BaguettePNG/PTrans-2025-2026/Documentation/Rapport_Tech_Final/main.pdf

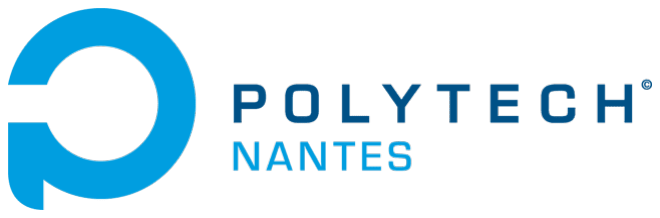
[picture p3: figure]

# RAPPORT TECHNIQUE FIN DE PROJET

## Projet transversal no

4

## Collecteur de données animalières

Équipe projet :
Davy Clark, Ewen Le Callet, Joris Menard, Jules Noumba, Xueying Xu

Client :
Xavier Leprevost – Élu de la mairie de Saint-Mars-du-Désert

Encadrants :
Abdelhakim Saadane et Antoine Goullet

Date :
09/03/2026

Année universitaire 2025–2026

## Remerciements

Nous tenons à remercier l’ensemble des personnes ayant contribué à la réalisation de ce projet transversal. Nous remercions particulièrement nos encadrants, Abdelhakim Saadane et Antoine Goullet, pour leur accompagnement, leurs conseils méthodologiques et leur disponibilité tout au long de l’année universitaire 2025–2026.
Nous remercions également notre client, Xavier Leprevost, élu de la mairie de Saint-Mars-du-Désert, pour sa confiance, la clarté de ses besoins et la qualité des échanges durant le développement du collecteur de données animalières.

## Table des matières

Remerciements | 1
Table des figures | 4
Glossaire | 5
1 Introduction | 6
2 Présentation, contexte et spécifications | 6
3 Liste des Work-Packages : Objectifs, Solution, Validation | 6
3.1 WP 1.1 — Détection de mouvement et mesure de température (responsable : Jules

3.2 WP 1.2 — Gestion des échanges données et du microcontrôleur (responsable : Nolan

4 Bilan du projet | 22
5 Conclusion | 22
Bibliographie | 23
Annexes | 24
A Répartition détaillée des Work-Packages | 24
B Exemples de données collectées | 24

## Table des figures

1 | Pinout Diagramme de l’ESP32 | | 9
2 | Module de carte SD utilisé pour le projet | 10
3 | Module de carte SD utilisé pour le projet | 10
4 | Résultat du test d’écriture sur la carte SD | 11
5 | Courbe de résistance en fonction de la luminosité pour la photorésistance | 13
6 | Module GPS utilisé pour le projet | 15
7 | Exemple de trame NMEA envoyée par le module GPS | 15
8 | Trame GPRMC utilisée pour récupérer la localisation et l’horodatage | 16
9 | Schéma du principe de fonctionnement du module RTC pour maintenir l’heure en
temps réel | 17
10 | Chaîne d’acquisition et de traitement des images du module caméra | 19
11 | Influence de la résolution sur la taille des images JPEG et le temps de capture . . . . 20

## Glossaire

WP Un Work Package (WP) est une unité de travail dans un projet. Il regroupe un ensemble cohérent de tâches, d’objectifs et de livrables.

## 1 Introduction

Le projet Collecteur de données animalières s’inscrit dans le cadre du projet transversal 2025– 2026 mené par des étudiants de Polytech Nantes en collaboration avec la mairie de Saint-Mars-du-Désert.
L’objectif principal est de concevoir une solution permettant de collecter, structurer et exploiter des données relatives à la faune locale, afin d’améliorer le suivi du territoire et d’appuyer la prise de décision.
Ce rapport technique présente le contexte du projet, les besoins exprimés par le client, les choix techniques retenus, ainsi que l’avancement des travaux réalisés par l’équipe. Par ailleurs, la structuration en lots de travail s’inspire des bonnes pratiques de gestion de projet recommandées dans la littérature[1]. Par ailleurs, la structuration en lots de travail s’inspire des bonnes pratiques de gestion de projet recommandées dans la littérature[1].

## 2 Présentation, contexte et spécifications

### 2.1 Présentation de l’entreprise

### 2.2 Contexte général

### 2.3 Présentation du sujet de projet et Cahier des Charges

### 2.4 Etat de l’art

## 3 Liste des Work-Packages : Objectifs, Solution, Validation

Parler de la décomposition des WP, sous WP etc

### 3.1 WP 1.1 — Détection de mouvement et mesure de température (respon-

sable : Jules Noumba)

### 3.1.1 Rappel des objectifs

Détailler objectifs et liste des taches.

### 3.1.2 Solution envisagé

Travail théorique et recherches

### 3.1.3 Tests et Validation

Tests et validation de vos taches.

### 3.2 WP 1.2 — Gestion des échanges données et du microcontrôleur (respon-

sable : Nolan Buchet)

### 3.2.1 Rappel des objectifs

Pour recontextuatlisé le projet et les objectifs de ce Work Package, le WP 1.2 fait partie du Work parckage 1 qui est dédié à la conception et au développement du système de collecte de données animalières. Le WP 1.2 se concentre spécifiquement sur la gestion des échanges de données entre les différents composants du système, ainsi que sur l’intégration et la programmation du microcontrôleur qui servira de cerveau central pour le projet. De plus celui-ci s’occupera de la partie énergétique du module, ainsi que de la partie stockage des données collectées.

Voici la liste des taches qui seront réalisées dans le cadre de ce WP :
— Tache 0 ( Equipe ) : Choix du Microcontrôleur et de la carte SD — Tache 1 : Gestion du stockage des données collectées
— Tache 2 ( hors WP ) : Gestion de la luminosité pour WP 1.3
— Tache 3 ; Gestion de l’horodatage et de la localisation du modules
— Tache 4 : Définition d’un Automate pour la gestion global du module — Tache 5 : Développement d’une architecture electrique
— Tache 6 : Intégration des modules ( prototypage )
— Tache 7 : Gestion de l’alimentation du module
— Tache 8 : Création d’un PCB pour le module

Pour chacune des taches réalisée ci-dessus, il y a eu une phase de test réalisé, ainsi qu’en amont une phase de concertation avec l’équipe du WP afin que les solutions envisagées soient en adéquation avec les besoins du projet.

Certaines tâches de ce modules ne sont pas dans l’ordre de conception, en prenant la tache 4 ou 5 qui ont été en constante évolution durant tout le projet. Et certaine taches non essentielle, mais logique, comme l’optimisation des codes, ou rapport / documention ont été réalisé en parallèle de la conception du module.

### 3.2.2 Tache 0 : Choix du Microcontrôleur

Solution envisagé

À la suite d’une phase de recherche ( benchmark du début de projet ) concernant le contrôleur à utiliser pour ce projet, nous avons identifié deux solutions susceptibles de répondre à nos besoins : l’ESP32 et le Raspberry Pi Zero.

Pour rappel, les besoins principaux concernant le contrôleur étaient les suivants :

Critère | Description
Consommation énergétique | Minimiser la consommation pour un usage sur bat- terie.

Performances | Garantir une puissance suffisante pour le traitement des données.
Stockage | Disposer d’une capacité suffisante pour enregistrer temporairement les mesures locales et la photogra- phie.
Système | Offrir un environnement logiciel simple avec facilité sur les outils de développement utilisés.
Interfaces | Proposer des entrées/sorties adaptées aux capteurs et modules externes.
Connectivités | Intégrer ou supporter le Wi-Fi, le Bluetooth ou d’autres moyens de communication.
Prix | Rester dans une gamme de coût compatible avec le budget du projet.

Ces critères nous ont permis de comparer plusieurs solutions techniques lors de la phase de benchmark.

Les critères suivants ont été considérés lors du choix final du microcontrôleur :
— Architecture matérielle
— Connectivité
— Consommation énergétique
— Nombre et type de GPIO
— Facilité de développement
— Coût global

À l’issue de l’analyse comparative réalisée entre l’ESP32 et le Raspberry Pi Zero, le choix s’est porté sur l’ESP32 comme microcontrôleur principal pour le collecteur de données animalières. Ce choix est motivé par plusieurs facteurs clés. Tout d’abord, sa faible consommation énergétique constitue un avantage décisif pour une utilisation sur batterie dans un environnement isolé. L’ESP32 peut fonctionner plusieurs jours, voire semaines, en mode basse consommation, ce qui garantit une autonomie optimale sur le terrain.

Ensuite, son intégration native du Wi-Fi et du Bluetooth simplifie la conception matérielle et réduit le besoin de modules externes, tout en permettant la transmission sans fil des données et la configuration à distance du système.

Enfin, son coût réduit et sa disponibilité sur le marché en font une solution économique et accessible, sans compromis majeur sur les performances nécessaires au projet. En revanche, il est à noter que le Raspberry Pi Zero offre une puissance de calcul et une mémoire supérieures, mais celles-ci sont jugées excessives au regard des besoins du projet et pénalisantes en termes de consommation énergétique et de gestion logicielle.

En conclusion, l’ESP32 répond pleinement aux exigences du projet en matière de consomma tion, de connectivité et de simplicité de déploiement, ce qui en fait la solution la plus adaptée pour le collecteur de données animalières.

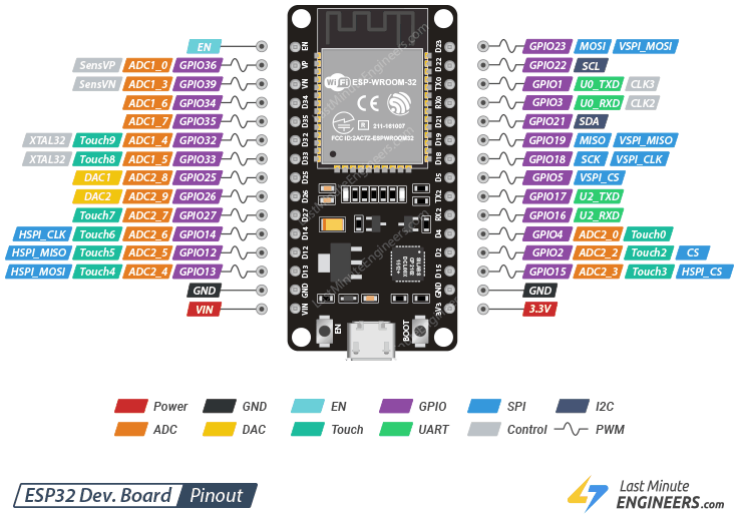
[picture p4: figure]

Figure 1 – Pinout Diagramme de l’ESP32

Notes : Un document détaillé présentant l’analyse comparative entre l’ESP32 et le Raspberry Pi Zero, ainsi que les critères de sélection, à été rédigé.

### 3.2.3 Tache 1 : Gestion du stockage des données collectées

Rappel des objectifs

Commençons par la tache 1 qui est la gestion du stockage des données collectées. Pour cette tache, il a été décidé d’utiliser une carte SD ( par cahier des charges ) pour stocker les données collectées par les métadatas et images. La carte SD offre une grande capacité de stockage, ce qui est essentiel pour notre projet De plus, les cartes SD sont relativement faciles à interfacer avec un microcontrôleur, ce qui facilite l’intégration dans notre système. Enfin celle ci est facilement accessible pour les utilisateurs, ce qui permet une récupération facile des données collectées.

Dons nous avons utilisé un module de carte SD utilisable en moyen de communication SPI, qui est un protocole de communication série rapide et efficace. Le microcontrôleur peut ainsi envoyer des commandes à la carte SD pour lire et écrire des données de manière rapide et fiable. Le module utilisé est un module personnel ( AZDelivery SPI Reader ), celui-ci à été choisi au début du projet car aucune commande n’étais envisageable de la part du département ou du client.

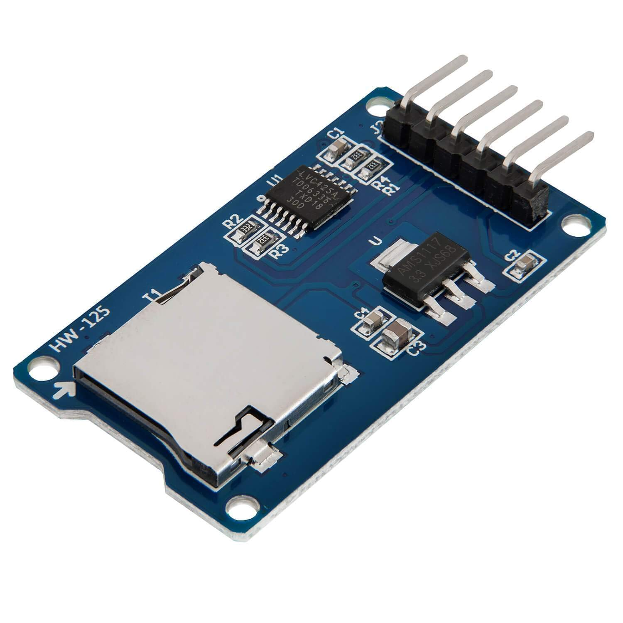
[picture p5: figure]

Figure 2 – Module de carte SD utilisé pour le projet

Solution envisagée

Pour utilisé le module, nous avons connecté notre esp32 à ce module en liaison SPI, en utilisant les broches suivantes :
— MOSI ( Master Out Slave In : Écriture ) : GPIO 13
— MISO ( Master In Slave Out : Lecture ) : GPIO 12
— SCK ( Serial Clock ) : GPIO 14
— CS ( Chip Select ) : GPIO 15
— VCC : 5V
— GND : GND

Nous utiliserons le module HSPI de l’ESP32 pour la communication SPI, qui permet des vitesses de transfert élevées. Voici un exmple de communication en SPI pour décrire le moyen de communication entre l’ESP32 et la carte SD.

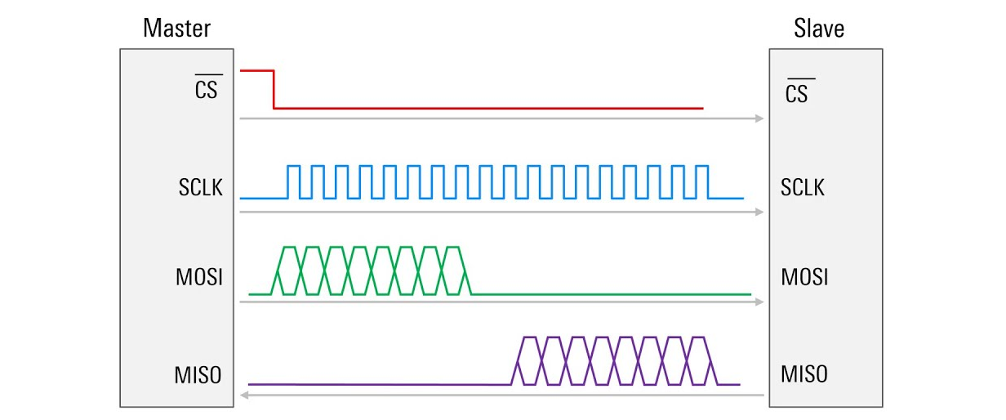
[picture p6: figure]

Figure 3 – Module de carte SD utilisé pour le projet

Pour utiliser ce module, une librairie toute faite à déja été développé, qu’il à suffit d’implémenter dans notre projet pour pouvoir utilisé la carte SD. Cette librairie est la librairie SD.h qui est une librairie standard pour la gestion des cartes SD avec les microcontrôleurs Arduino et ESP32. Elle offre des fonctions pour initialiser la carte SD, lire et écrire des fichiers, et gérer les répertoires. Nous l’avons utilisé pour crée ntre propre bibliothèque visant à simplificer l’utilisation de cette carte avec notement le WPBis qui est dédier à la gestion de la transmission des données collectées.

Tests et Validation

Pour la phase de test, nous avons juste réalisé un test afin de savoir si nous pouvions écrire un fichier texte sur la carte SD, En donnant comme Nom de fichier les métadatas ( comme température, humidité, etc ), afin de simulé un buffer de réception d’images avec les données correspondantes.

Voici un exemple de code utilisé pour ce test :

1 # include < SD_PIEGE .h >

2
3 | void setup ()
4 | {
5 | initSD () ;

6
7 | // Temperature_Humidite_Latitude_Longitude_Heure_Minute_Seconde
8 | String filename = "20 _60_47 -2833012 _1 -5152623 _10 -30 -30. txt ";

9
10 | File file = SD . open ( filename , FILE_WRITE ) ;

11
12 | // Exemple de donnees JPEG
13 | uint8_t image [] = {0 xFF , 0 xD8 , 0 xFF , 0 xE0 , 0 x00 , 0 x10 , 0 x4A , 0 x46 };

14
15 | file . write ( image , sizeof ( image ) ) ;
16 | file . close () ;
17 | }

Listing 1 – Exemple utilisation module SD

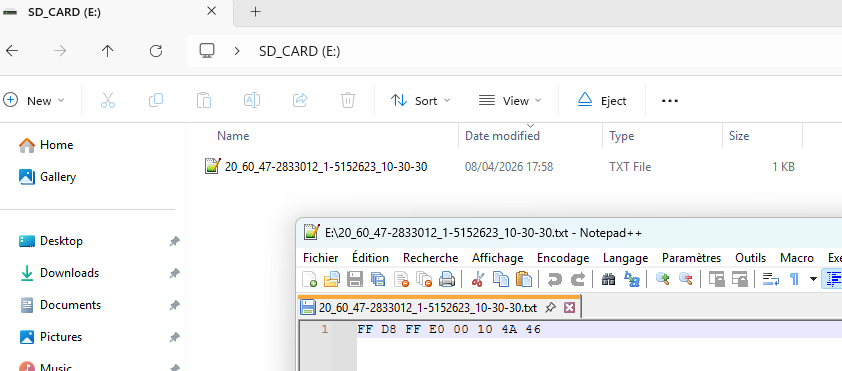
[picture p7: figure]

Figure 4 – Résultat du test d’écriture sur la carte SD

### 3.2.4 Tache 2 : Hors WP : Gestion de la luminosité pour WP 1.3

Rappel des objectifs

Pour cette partie nous avons décidé de me séparé de mon WP afin d’aider le WP 1.3 qui est dédié à la gestion de la caméra, notamment pour la partie de la luminosité. En effet, la luminosité est un facteur important pour la prise de vue des images, car d’après notre cahier des charges, nous voulions prendre des photographie de jour comme de nuit.

Avoir la possibilité de connaitre la luminosité de l’environnement, nous permettrai de pourvoir allumer une source de lumière ( comme des LED Infrarouge ) pour pouvoir capturer des élement de nuit.

Solution envisagée

Pour cela nous avons décidé d’ajouter un capteur de luminosité ( une photorésistance ( LDR )) afin de capturer la luminosité de l’environnement. Ce capteur est un composant électronique qui change de résistance en fonction de la quantité de lumière. C’est un capteur très simple à mettre en œuvre et à interfacer avec un microcontrôleur comme l’ESP32. En mesurant la résistance de la photorésistance, nous pouvons déterminer la luminosité ambiante et ajuster le comportement de notre système.

Pour connaitre la résistance de ce capteur, nous utilisons un montage de diviseur de tension, qui nous permet de convertir la résistance variable de la photorésistance en une tension mesurable par l’ESP32. Voici un schéma de ce montage :

Dans ce montage, la photorésistance ( LDR ) est connectée en série avec une résistance fixe ( R1 ). Lorsque la lumière frappe la photorésistance, sa résistance change, ce qui modifie la tension de sortie ( Vout ) du diviseur de tension. En mesurant cette tension de sortie avec l’ESP32, nous pouvons calculer la résistance de la photorésistance et ainsi déterminer la luminosité ambiante.

RLDR = ((Rserie ∗ 3.3)/T ensionV out) − Rserie;

A partir de la documention technique de la LDR nous pouvons facilement retrouver la valeur de la luminausité ( en LUX ) à partir de la résistance de la résistance, en utilisant la courbe suivante :

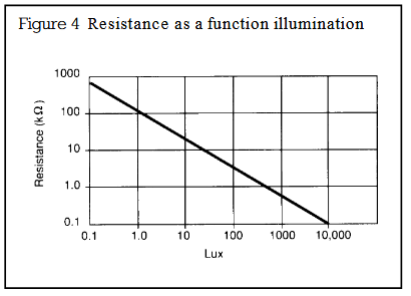
[picture p8: figure]

Figure 5 – Courbe de résistance en fonction de la luminosité pour la photorésistance

Lux = ( 1000 Resistance
)

1.4

Tests et Validation

Pour la phase de test de cette LDR nous avons tous simplement effectué plusieur mesure avec des taux de luminosité différent, en utilisant une lampe, chiffon, rideau, etc ... pour faire varier la luminosité, et en mesurant la tension de sortie du diviseur de tension.

Pour lire la valeur numérique nous avons tout simplement utilisé la fonction analogRead() de l’ESP32, qui nous permet de lire la tension de sortie.

Voici un exemple de code utilisé pour ce test :

1 | # define LDR_PIN 34 // Broche analogique pour la LDR
2 | # define RESISTOR_BRIDGE 10000 // Resistance diviseur de tension

3
4 | void setup ()
5 | {
6 | Serial . begin (115200) ;
7 | }

8
9 | void loop ()
10 | {
11 | // Calcul de la tension ( ADC 12 bits )
12 | ldrValue = ( analogRead ( LDR_PIN ) * 3.3) / (1.0 * 4095.0) ;

13

14 | // Calcul de la reistance
15 | float resistance = (( RESISTOR_BRIDGE * 3.3 ) / ldrValue ) -
| RESISTOR_BRIDGE ;

16
17 | // Calcul de la luminosite en LUX
18 | float lux = pow ((1000 / resistance ) , 1.4) ;

19
20 | Serial . print ("LDR Value : ") ;
21 | Serial . println ( ldrValue ); // Affichage de la valeur lue

22
23 | Serial . print (" Resistance : ") ;
24 | Serial . println ( resistance ) ; // Affichage de la resistance calculee

25
26 | Serial . print (" Luminosite ( LUX ): ") ;
27 | Serial . println ( lux ) ; // Affichage de la luminosite calculee

28
29 | delay (1000) ; // Attente d’une seconde avant la prochaine lecture
30 | }

Listing 2 – Exemple utilisation LDR

Avec ce code nous avons pu vérifier que notre capteur LDR fonctionnait comme un luxmètre, en affichant la valeur de luminosité en LUX dans le moniteur série de l’ESP32. Nous avons en même temps vérifier à l’aide d’une lumètre ( téléphone ) que les valeurs de luminosité affichées étaient cohérentes avec les mesures réelles. Malheureusement le téléphone utilisant une application celui-ci n’était pas très précis.

Mais dans l’ensemble des résultats obtenus étaient cohérents, on a obtenue :

| Theorie (Calcul) | Numerique (Code) | Pratique (Multimetre + Tel)
Tension | Resistance | Lux | Tension | Resistance | Lux | Tension | Resistance | Lux (PAS FIABLE)
Noir (Torchon) | 0 | 1M | 0,1 | 0 | 1M | 1 | 0 | 17,16M | 0
Sombre | | | | 0,69 | 5668 | 2636 | 0,7 | 5300 | 100
Gris | | | | 2 | 996 | 10000 | 2,13 | 890 | 500
Lumiere | | | | 2,71 | 329 | 10000 | 2,8 | 237 | 1900
Flash | 3,3 | 0,1 | 10000 | 3,3 | 0 | 10000 | 3,22 | 72,3

Table 2 – Comparaison des mesures de luminosite : theorie, calcul numerique et mesures pratiques

### 3.2.5 Tache 3 : Gestion de l’horodatage et de la localisation du modules

Rappel des objectifs

Pour cette tache, nous avons décidé d’ajouter un module GPS afin de pouvoir récupérer la localisation du module, ainsi que l’heure grâce à ce module. En effet, les données d’horodatage sont necessaires pour pouvoir avoir des statistique sur le taux de passage dans la zone en question, et la localisation est nécessaire dans le cas nous aurions plusieurs modules à déployer, afin d’observer les zonnes de passage.

Nous avons décidé d’utiliser un module GPS personnel ( dans le même cas que pour la carte SD, aucune commande n’était envisageable de la part du département ou du client ), qui est un module basique déstiné plutot pour les drones FPV.

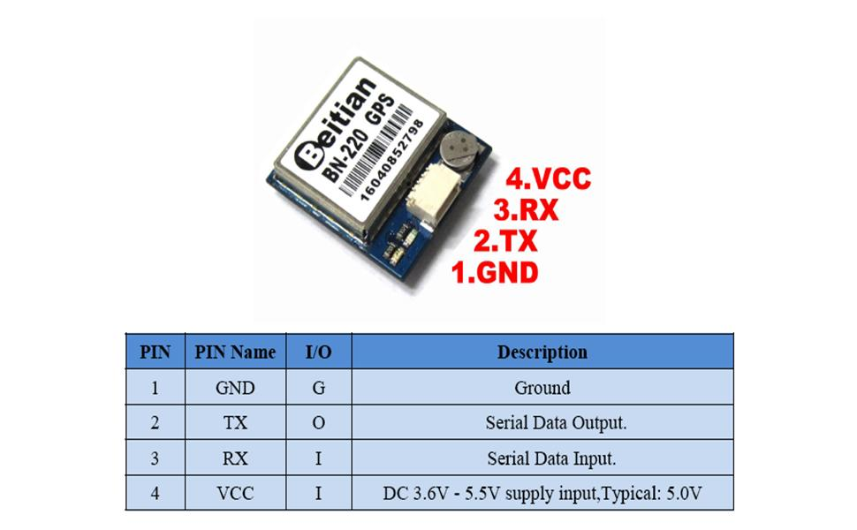
[picture p9: figure]

Figure 6 – Module GPS utilisé pour le projet

Solution envisagée - GPS

Ce module est basé sur une communication Série UART, qui est un protocole de communication simple et largement utilisé pour les modules GPS. Celui ci envoie des données de localisation et d’horodatage au format NMEA, qui est un format standard pour les données GPS. Différentes trames NMEA contiennent différentes informations, telles que la position, la vitesse, l’heure, etc.

Pour exemple la trame la plus connue est celle de GGA, qui est :

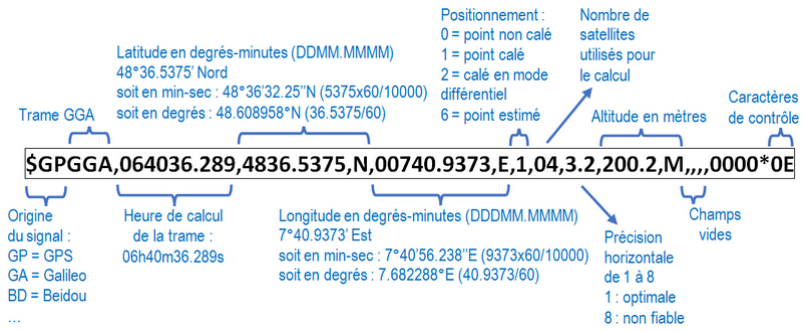
[picture p10: figure]

Figure 7 – Exemple de trame NMEA envoyée par le module GPS

Dans notre cas nous allons utiliser la trame GPRMC :

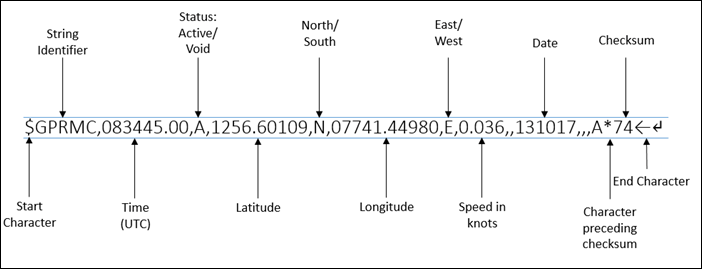
[picture p11: figure]

Figure 8 – Trame GPRMC utilisée pour récupérer la localisation et l’horodatage

Grace à cette trame, nous allons pouvoir récupérer l’heure ( UTC ), la latitude, la longitude.

Pour l’implémentation de ce module, nous avons crée notre librairie Arduino visant à récuper les informations que nous shouaitons à partir des information communication en liaisons UART.

Le principe est simple nous attendons qu’une trame complète soit arrivée, nous anaylison sur le carractère du début est bien $GPRMC et nous analysons les caractère qui sont séparé par des virgules pour récupérer les différentes informations. A la suite de ça nous avons crée une class en c permettant de pouvoir récupér les valeur directement via une simple fonction, get().

Solution envisagée - RTC

Pour la partie du GPS nous avons pu voir que nous pouvions récupérer toute les inforamtions néecssaire à notre projet, cependant il y avait un probleme, le GPS met du temps à se capter la localisation car celui-ci dépend de la position des satellites, et dans le cas ou le module est dans une zone isolé, il peut mettre du temps à se capter la localisation.

Une solution était d’utiliser un module RTC ( Real Time Clock ), celui si permettrait de continuer à obtenir l’heure sans pour autant avoir besoin d’utiliser le module GPS, ce qui nous permettrait de gagner du temps sur tout le cheminement de la capture à la transmission.

Un module RTC est un composant électronique qui maintient une horloge en temps réel, même lorsque le microcontrôleur est éteint ou redémarré. Voici un schéma du principe que nous voulions implémenter :

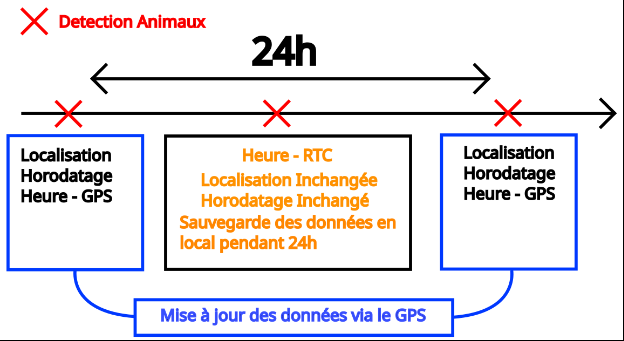
[picture p12: figure]

Figure 9 – Schéma du principe de fonctionnement du module RTC pour maintenir l’heure en temps réel

Pour l’implémentation de ce module, nous avons implémenter notre propre librairie qui vise à récupérer

Tests et Validation

### 3.3 WP 1.3 — Caméra (responsable : Xueying Xu)

### 3.3.1 Rappel des objectifs

Le work package WP1.3 correspond au module caméra du système.
Son objectif principal est de permettre la prise d’images dans le cadre du piège caméra, afin de récupérer des données exploitables sur les animaux détectés.
Plus concrètement, les tâches associées sont :
— Capturer une image lorsqu’un signal de déclenchement est reçu (capteur ou commande)
— Générer des images dans un format adapté, notamment le format JPEG
— Assurer un fonctionnement en conditions de jour comme de nuit, avec un mode nocturne basé sur un éclairage infrarouge
— Obtenir une qualité d’image suffisante pour permettre une observation correcte
— Assurer que les images puissent être utilisées par les autres modules, en particulier le module MCU (WP1.2) et l’interface web (WP2.2)
— Étudier l’influence de certains paramètres (résolution, distance, etc.) sur la qualité et la taille des images
Au début du projet, plusieurs solutions ont été testées (Raspberry Pi, ESP32-CAM) afin de valider le fonctionnement global. La solution matérielle finale étant traitée dans le WP1.2, cette partie se concentre surtout sur la gestion des images et leur format.
Dans ce contexte, nous avons mené une étude spécifique sur le choix du format d’image ainsi que sur son impact sur le système global. En particulier, le format JPEG a été analysé en lien avec la taille des données, la qualité de l’image et les contraintes de transmission. Parallèlement, nous avons également réalisé plusieurs tests afin d’évaluer l’influence de la résolution et des conditions de prise de vue sur le module caméra et la qualité de l’image.

### 3.3.2 Solution envisagée

Afin de répondre aux objectifs du WP1.3, une solution basée sur l’acquisition et la gestion d’images au format JPEG a été retenue.
Une phase de prototypage a d’abord été réalisée à l’aide de différentes plateformes (Raspberry Pi puis ESP32-CAM) afin de valider le principe de capture d’image et de transmission. La solution matérielle finale étant traitée dans le WP1.2, cette partie se concentre principalement sur le traitement des images.
La chaîne de fonctionnement mise en place est illustrée sur la figure ci-dessous. Elle comprend le déclenchement de la capture, l’acquisition de l’image, la génération d’une image compressée au format JPEG, puis son stockage temporaire avant exploitation par les autres modules du système.

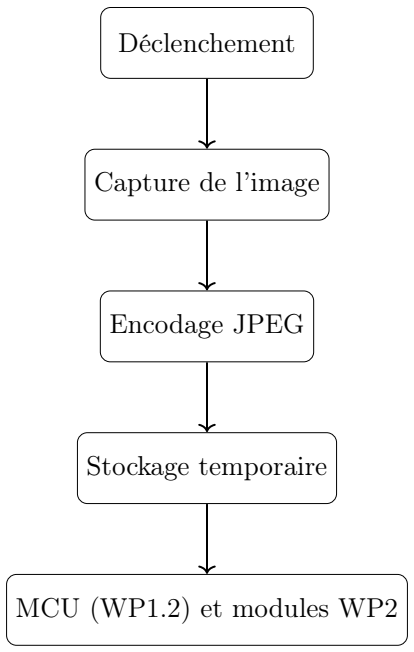
[picture p13: figure]
Déclenchement; Capture de l’image; Encodage JPEG; Stockage temporaire; MCU (WP1.2) et modules WP2

Figure 10 – Chaîne d’acquisition et de traitement des images du module caméra

Choix du capteur OV2640 Le capteur OV2640 a été retenu car il est bien adapté à une application embarquée de faible coût. Il est compatible avec l’ESP32 et permet de produire directement des images exploitables dans le système.
Son fonctionnement repose sur la conversion de la lumière captée par le capteur en données numériques. Ces données peuvent ensuite être traitées afin de générer une image compressée au format JPEG, qui sera récupérée par le microcontrôleur pour être stockée ou transmise.
Ce choix présente plusieurs avantages dans le cadre du projet :
— génération directe d’images JPEG ;
— réduction de la charge de traitement côté microcontrôleur ;
— taille de données plus adaptée à la transmission ;
— bonne intégration dans une architecture embarquée.

Principe du format JPEG Le format JPEG repose sur une compression avec perte, ce qui permet de réduire fortement la taille des images. Son principe est de représenter l’image en séparant les informations les plus importantes de celles qui le sont moins pour l’œil humain.
D’un point de vue théorique, l’image est découpée en blocs, puis chaque bloc est transformé dans le domaine fréquentiel, généralement par une transformée en cosinus discrète (DCT). Les coefficients obtenus sont ensuite quantifiés : les composantes les moins importantes, souvent associées aux hautes fréquences, sont réduites ou supprimées. Cette étape permet de diminuer fortement la quantité de données à stocker ou à transmettre.
Dans notre cas, ce format est particulièrement intéressant car il permet de réduire la taille des données tout en conservant une qualité visuelle suffisante pour l’observation et l’exploitation des images dans le système global.
Par ailleurs, un fonctionnement en mode jour et nuit a été pris en compte. En conditions de faible luminosité, un éclairage infrarouge permet de maintenir la capture d’images.

### 3.3.3 Tests et Validation

Afin d’évaluer les performances de la chaîne d’acquisition d’image sur plateforme ESP32, nous avons réalisé une série de tests.
Tout d’abord, nous avons vérifié le format des images générées. Les résultats montrent que le module peut correctement générer des images au format JPEG, et que ces images peuvent être utilisées par les autres modules du système.
De plus, nous avons étudié l’influence de la résolution sur la taille des images. Les résultats montrent qu’avec l’augmentation de la résolution, la taille des images augmente également, passant de quelques kilooctets en basse résolution (QQVGA) jusqu’à environ 30 kB en haute résolution (XGA). Comme illustré sur la figure ci-dessous, une augmentation de la résolution entraîne une augmentation de la taille des images ainsi qu’un impact sur le temps de capture.

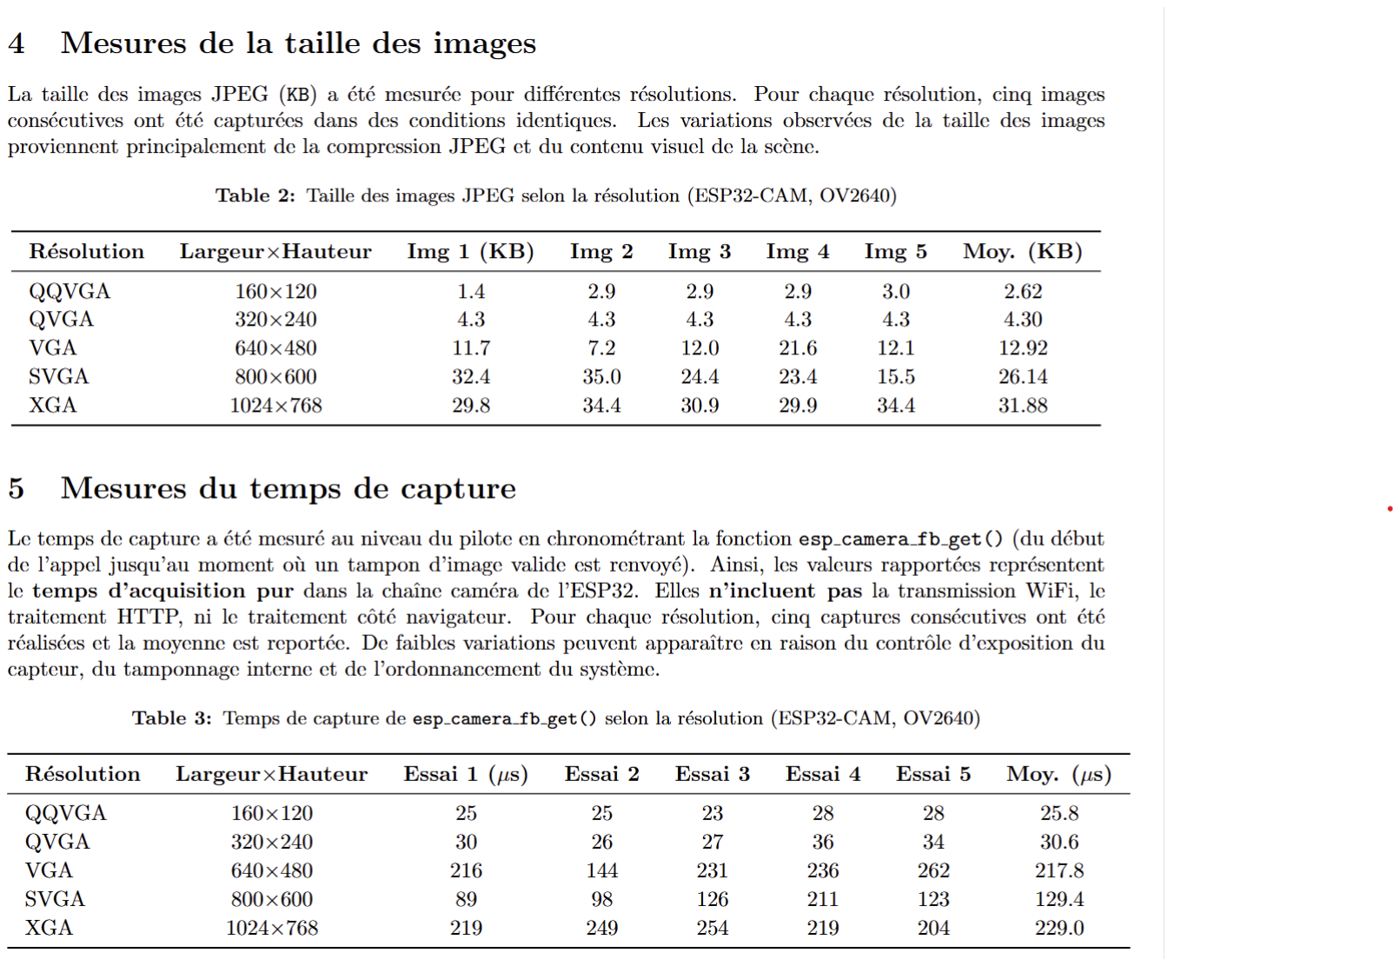
[picture p14: figure]

Figure 11 – Influence de la résolution sur la taille des images JPEG et le temps de capture

Nous avons également analysé le temps de capture des images. Les résultats montrent que le temps de capture est globalement faible, mais qu’il varie en fonction de la résolution. Cependant, la latence globale provient principalement de la transmission WiFi ainsi que du traitement côté client. Enfin, nous avons testé la qualité des images à différentes distances de prise de vue. Les résultats montrent que la qualité est bonne à courte distance, mais qu’elle diminue progressivement lorsque la distance augmente.
Globalement, ces résultats montrent que le module caméra fonctionne correctement et qu’il répond aux besoins du projet en termes de qualité d’image et de transmission des données.

### 3.4 WP 1.4 — Conception et fabrication du boitier (responsable : Joris Me-

nard)

### 3.4.1 Rappel des objectifs

Détailler objectifs et liste des taches.

### 3.4.2 Solution envisagé

Travail théorique et recherches

### 3.4.3 Tests et Validation

Tests et validation de vos taches.

### 3.5 WP bis — Transmission (responsable : Joris Menard)

### 3.5.1 Rappel des objectifs

Détailler objectifs et liste des taches.

### 3.5.2 Solution envisagé

Travail théorique et recherches

### 3.5.3 Tests et Validation

Tests et validation de vos taches.

### 3.6 WP 2.1 — Stockage distant (responsable : Davy Clark)

### 3.6.1 Rappel des objectifs

Détailler objectifs et liste des taches.

### 3.6.2 Solution envisagé

Travail théorique et recherches

### 3.6.3 Tests et Validation

Tests et validation de vos taches.

### 3.7 WP 2.2 — Interface web (responsable : Xueying Xu)

### 3.7.1 Rappel des objectifs

Le work package WP2.2 correspond à l’interface web du système. Son objectif principal est de permettre à l’utilisateur de consulter et gérer les données collectées par le piège caméra de manière simple et accessible via un navigateur web. Plus concrètement, les tâches associées sont :
— Afficher les images capturées par le module caméra
— Permettre un accès au système via une interface web (adresse IP / site)
— Associer aux images certaines informations (date, heure, etc.)

— Visualiser l’état du système (caméra, batterie, etc.)
— Proposer différentes fonctionnalités (visualisation des images, gestion des caméras, journal système, etc.)
— Offrir une interface claire et intuitive pour l’utilisateur
Cette interface constitue le lien entre le système embarqué et l’utilisateur final.

### 3.7.2 Solution envisagé

Travail théorique et recherches

### 3.7.3 Tests et Validation

Tests et validation de vos taches.

### 3.8 WP 2.3 — Classification animalière par IA (responsable : Ewen Le Callet)

### 3.8.1 Rappel des objectifs

Détailler objectifs et liste des taches.

### 3.8.2 Solution envisagé

Travail théorique et recherches

### 3.8.3 Tests et Validation

Tests et validation de vos taches.

## 4 Bilan du projet

### 4.1 Bilan technique

### 4.2 Bilan personnel

## 5 Conclusion

## Bibliographie

## Références

[1] Project Management Institute, A Guide to the Project Management Body of Knowledge (PM-BOK Guide), 7e
édition, 2021.

## Annexes

## A Répartition détaillée des Work-Packages

Cette annexe peut contenir un tableau de suivi des tâches par membre, avec les dates de début, d’échéance et le statut d’avancement.

## B Exemples de données collectées

Cette annexe peut présenter des exemples de relevés (température, horodatage, détection de mouvement), ainsi que des captures d’écran de l’interface web.
