BaguettePNG/PTrans-2025-2026/Architecture/Main-REVA2/Projet/3D_1.png

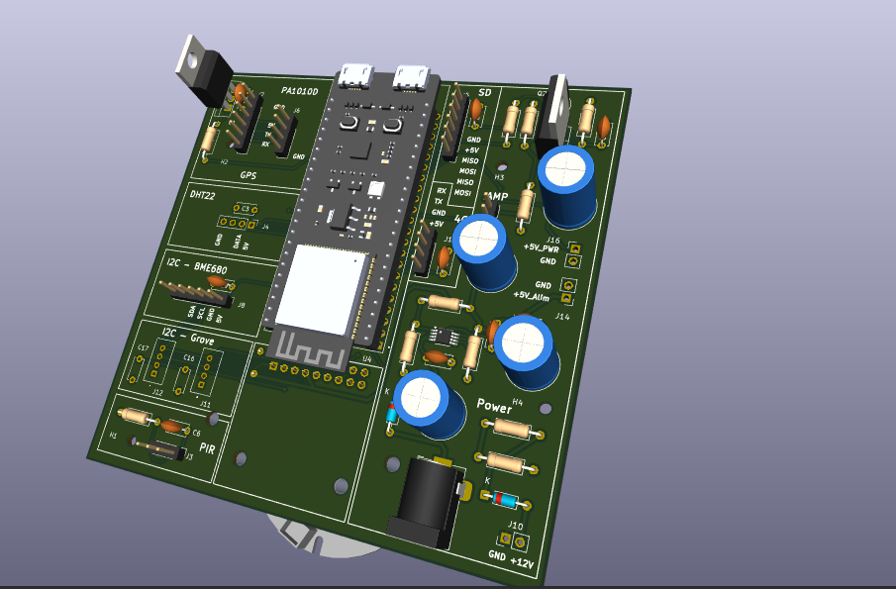
Architecture/Main-REVA2/Projet/3D_1.png
