BaguettePNG/PTrans-2025-2026/Documentation/CR/Proto/Image/Cone.jpeg

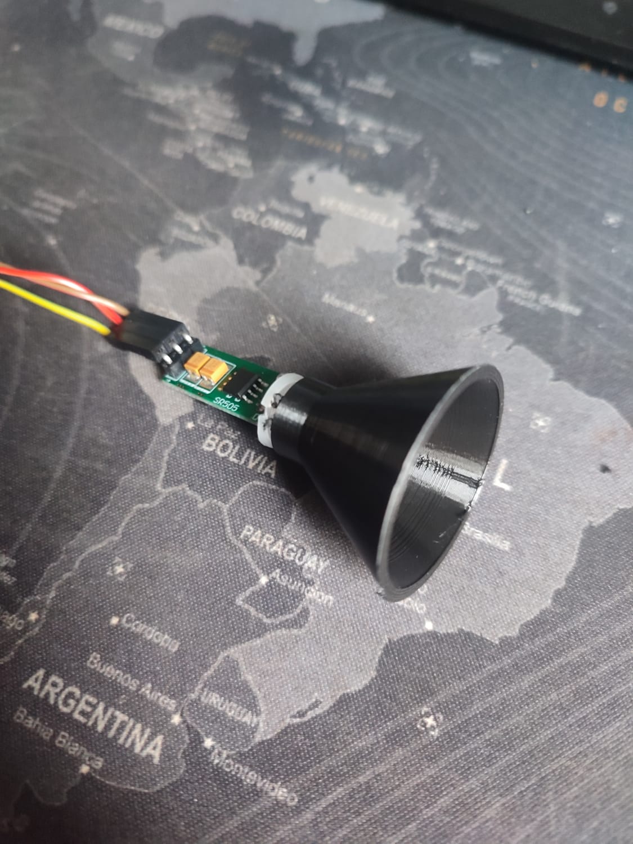
Documentation/CR/Proto/Image/Cone.jpeg
