BaguettePNG/PTrans-2025-2026/Documentation/CR/Proto/Image/Espacil_1.jpeg

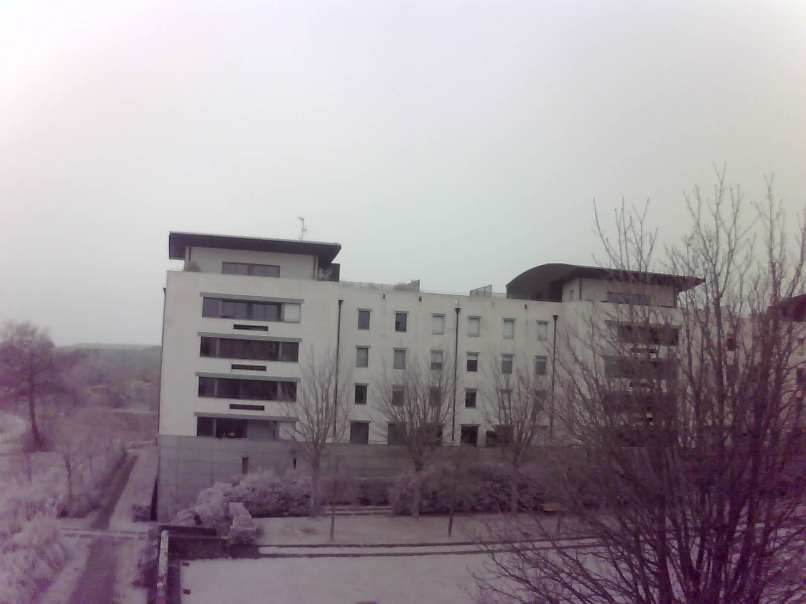
Documentation/CR/Proto/Image/Espacil_1.jpeg
