BaguettePNG/PTrans-2025-2026/Documentation/CR/Proto/Image/image.png

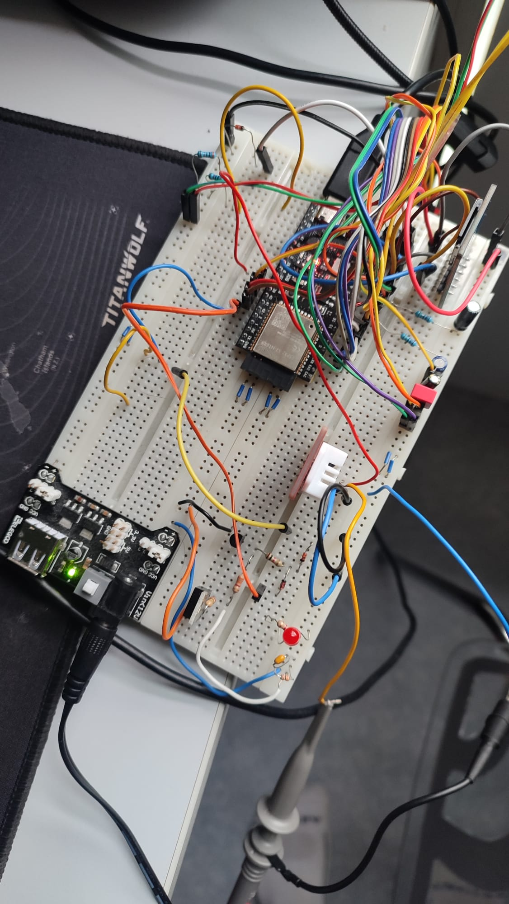
Documentation/CR/Proto/Image/image.png
