BaguettePNG/PTrans-2025-2026/Documentation/CR/Proto/Image/Schema.png

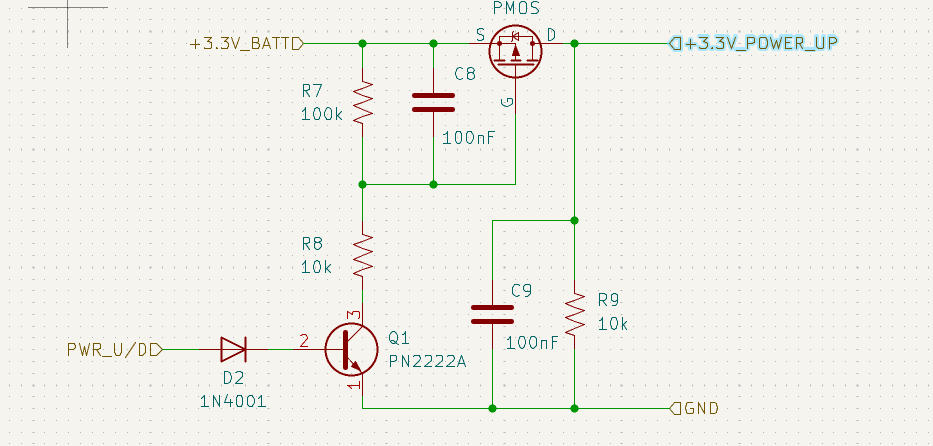
Documentation/CR/Proto/Image/Schema.png
