BaguettePNG/PTrans-2025-2026/Documentation/CR/Proto/Image/WhatsApp Image 2026-01-18 at 18.57.16.jpeg

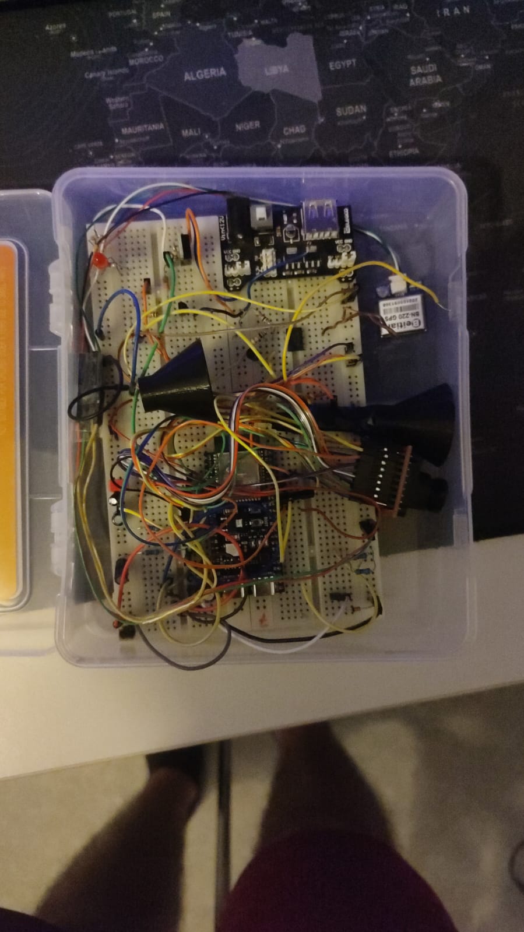
Documentation/CR/Proto/Image/WhatsApp Image 2026-01-18 at 18.57.16.jpeg
