BaguettePNG/PTrans-2025-2026/Documentation/Rapport_Tech_Final/Images/WP1_2/Tache_2/couronne_1.jpg

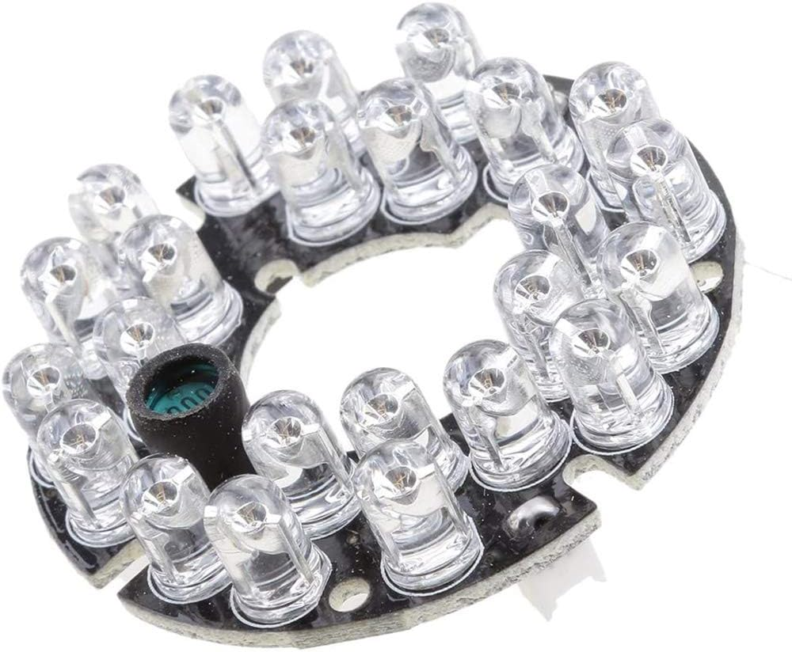
Documentation/Rapport_Tech_Final/Images/WP1_2/Tache_2/couronne_1.jpg
