BaguettePNG/PTrans-2025-2026/Documentation/Rapport_Tech_Final/Images/WP1_2/Tache_5/Frequence.png

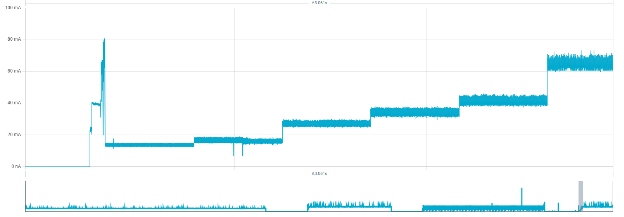
Documentation/Rapport_Tech_Final/Images/WP1_2/Tache_5/Frequence.png
