BaguettePNG/PTrans-2025-2026/Documentation/Rapport_Tech_Final/Images/WP1_2/Tache_6/ESP32-architect.png

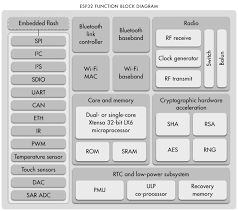
Documentation/Rapport_Tech_Final/Images/WP1_2/Tache_6/ESP32-architect.png
