BaguettePNG/PTrans-2025-2026/Documentation/Rapport_Tech_Final/Images/WP1_2/Tache_6/ESP32-S3-N16R8.jpg

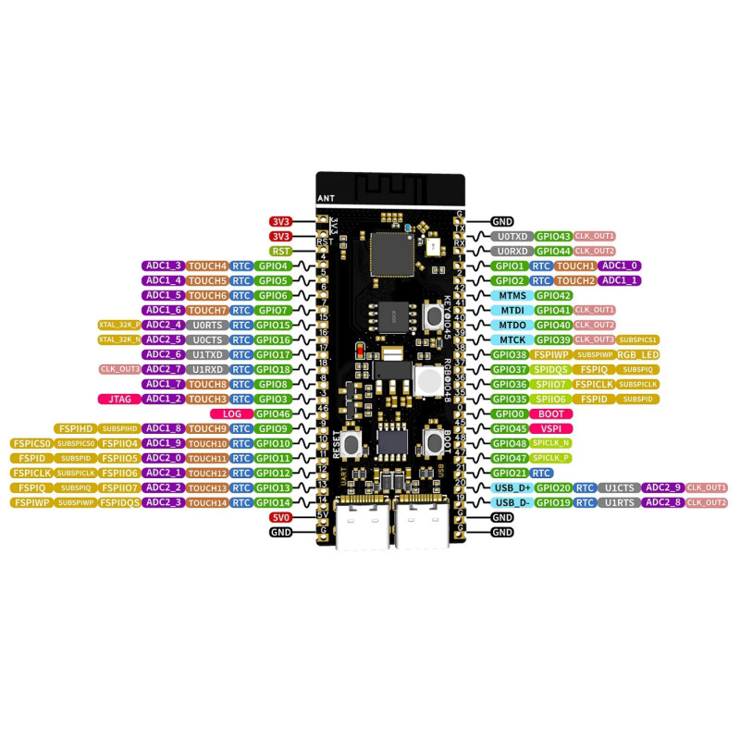
Documentation/Rapport_Tech_Final/Images/WP1_2/Tache_6/ESP32-S3-N16R8.jpg
