BaguettePNG/PTrans-2025-2026/Documentation/Rapport_Tech_Final/Images/WP1_2/Tache_7/uc.png

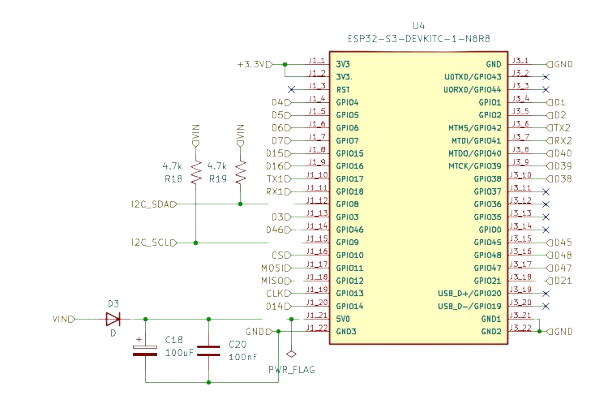
Documentation/Rapport_Tech_Final/Images/WP1_2/Tache_7/uc.png
