BaguettePNG/PTrans-2025-2026/Documentation/Rapport_Tech_Final/Images/WP1_2/Tache_8/3DPCB_BOT.png

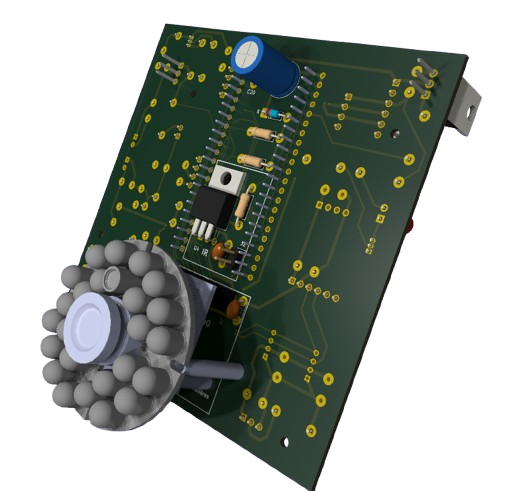
Documentation/Rapport_Tech_Final/Images/WP1_2/Tache_8/3DPCB_BOT.png
