BaguettePNG/PTrans-2025-2026/Documentation/Rapport_Tech_Final/mesures_camera.png

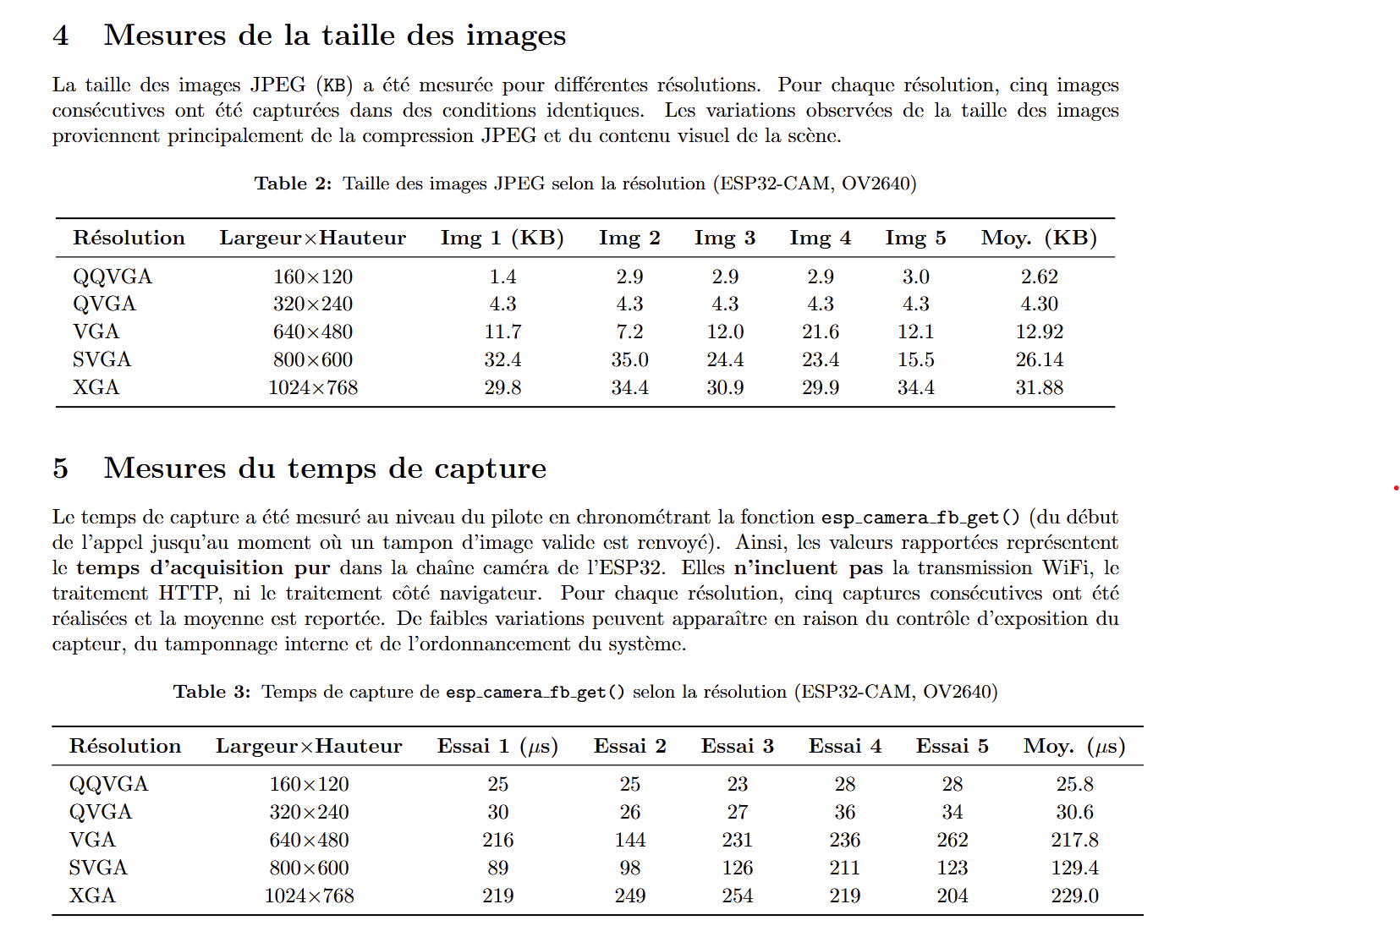
Documentation/Rapport_Tech_Final/mesures_camera.png
