BaguettePNG/PTrans-2025-2026/Documentation/Rapport_Tech_Final/preview_page1.png

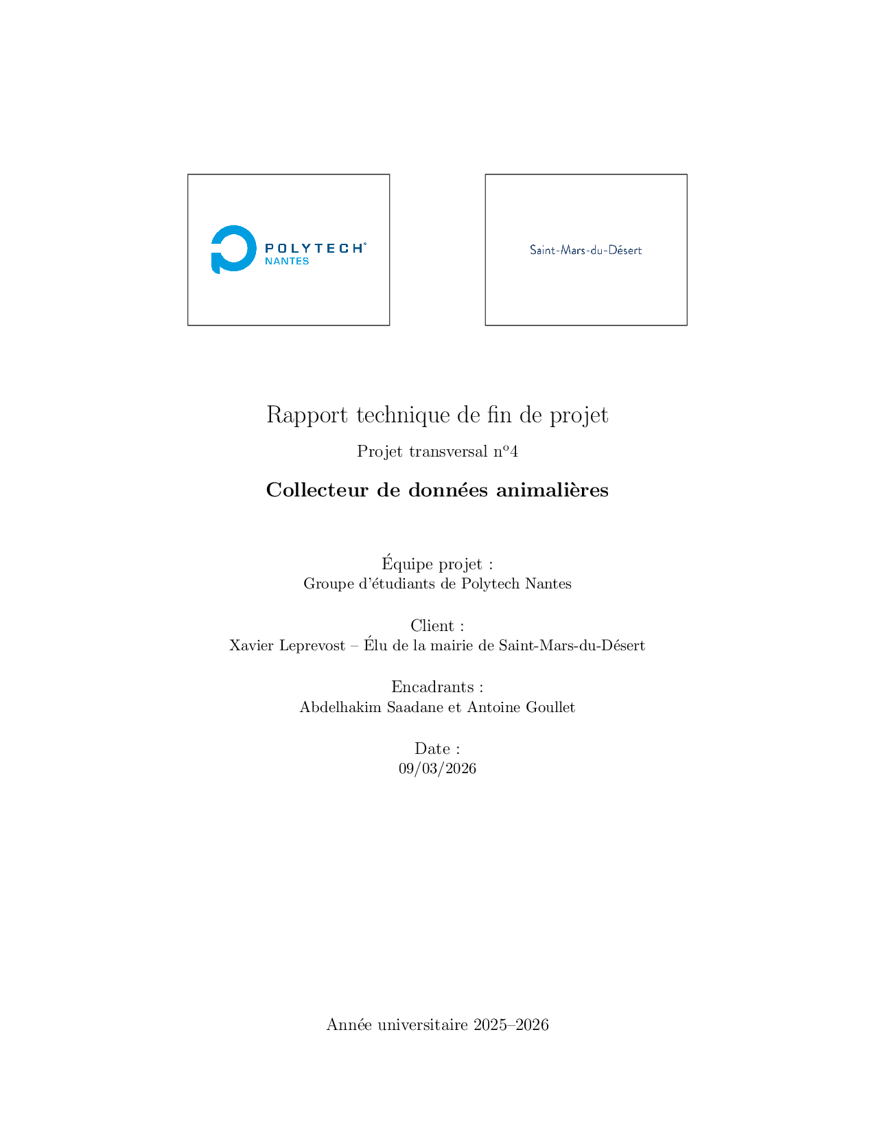
Documentation/Rapport_Tech_Final/preview_page1.png
