BaguettePNG/PTrans-2025-2026/Rapport/Rapport_Avancement/Images/images_nolan/Schema_Bloc.png

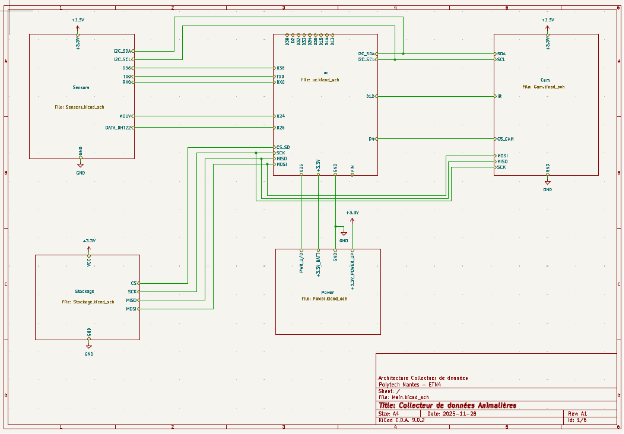
Rapport/Rapport_Avancement/Images/images_nolan/Schema_Bloc.png
