BaguettePNG/PTrans-2025-2026/Modelisation_3D/Support_LEDIR.STEP

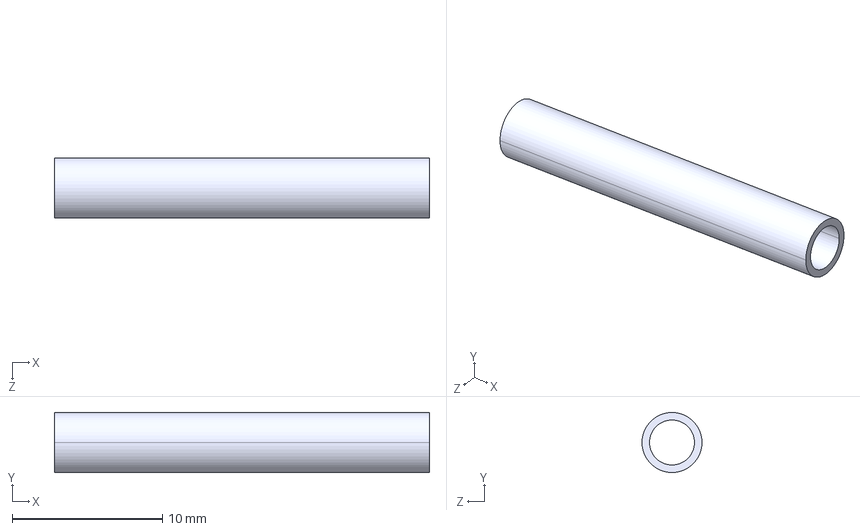
[picture p58: CAD file, 2026-02-01]
Modelisation_3D/Support_LEDIR.STEP
25.0 x 4.00 x 4.00 mm
