BaguettePNG/PTrans-2025-2026/Modelisation_3D/Support_CAM_ENTRE.STEP

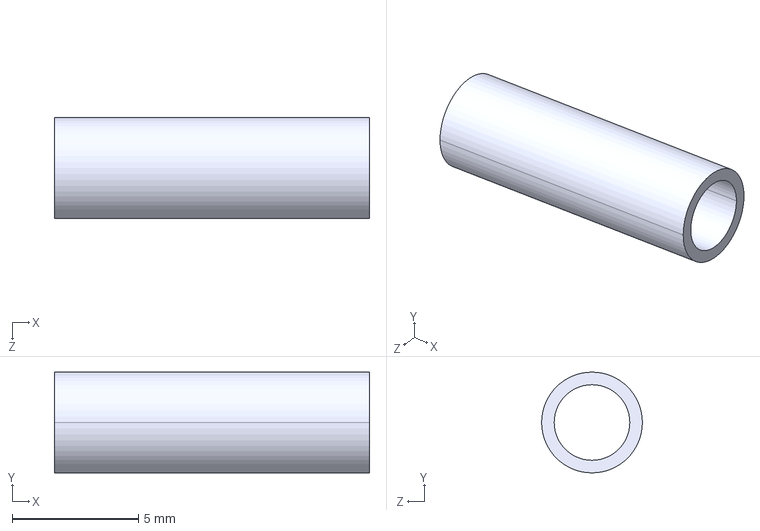
[picture p59: CAD file, 2026-02-01]
Modelisation_3D/Support_CAM_ENTRE.STEP
12.5 x 4.00 x 4.00 mm
