BaguettePNG/PTrans-2025-2026/Modelisation_3D/OV2640.SLDPRT

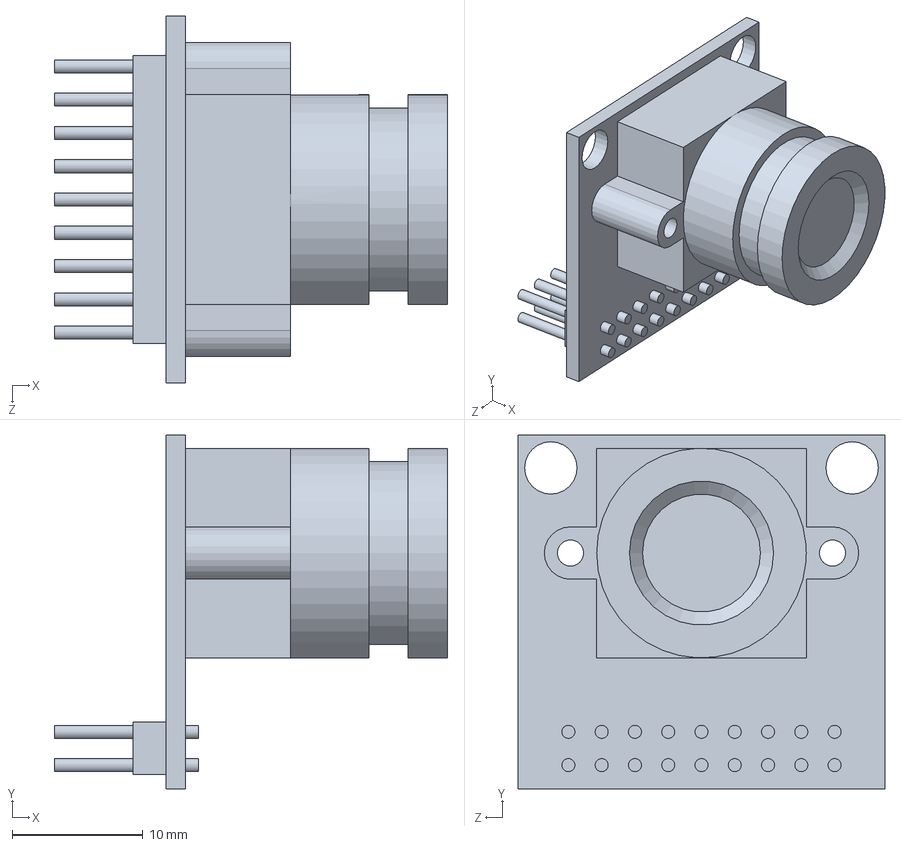
[picture p60: CAD file, 2026-01-28]
Modelisation_3D/OV2640.SLDPRT
30.0 x 27.0 x 28.0 mm
