BaguettePNG/PTrans-2025-2026/Modelisation_3D/LED_IR.step

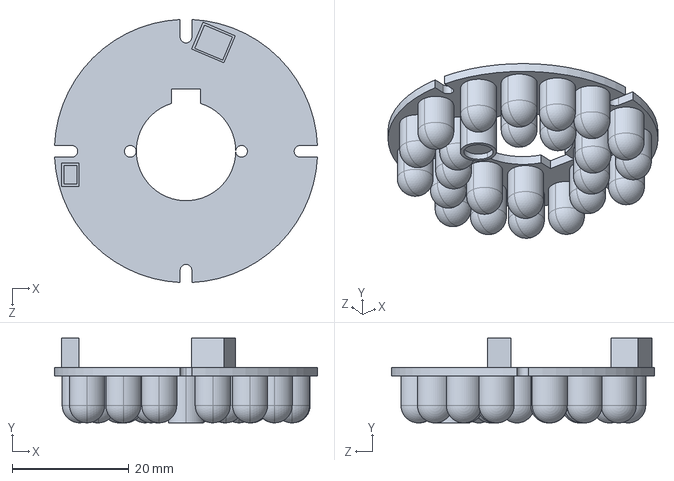
[picture p61: CAD file, 2026-01-28]
Modelisation_3D/LED_IR.step
45.0 x 14.5 x 45.0 mm
