BaguettePNG/PTrans-2025-2026/(list of files, cad)

Other CAD files:
Modelisation_3D/Support_CAM.STEP
Modelisation_3D/LED_IR.SLDPRT
Modelisation_3D/Support_CAM.SLDPRT
Modelisation_3D/Support_LEDIR.SLDPRT
