BaguettePNG/PTrans-2025-2026/ESP32_TEST/image_ov7670.png

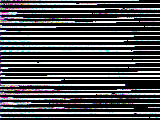
ESP32_TEST/image_ov7670.png
