BaguettePNG/PTrans-2025-2026/ESP32_TEST/image_reconstruite.png

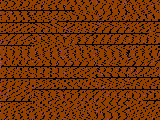
ESP32_TEST/image_reconstruite.png
