BaguettePNG/PTrans-2025-2026/(commit log)

2025-12-30 Update Schematic
    [Cam.kicad_sch]
2025-12-31 Power Sector Update
    [Power.kicad_sch]
